esper256/smart-sewer-backup-detector/firmware/src/sewer-backup-detector.cpp

// Particle Photon 2 — sewer backup detector
// Device OS 5.3.2+. Edit config_and_secrets.h.
//
// Dry contact D2–GND, INPUT_PULLUP. Debug LED on D7.
// Closed (clear) => LOW => OFF. Open (sewer backup or cut wire) => HIGH => ON.
// ON/OFF are Home Assistant moisture binary_sensor payloads (on = Wet).
// Automations decide whether a sewer backup is an alarm.

#include "Particle.h"
#include "config_and_secrets.h"

#ifdef SEWER_TRANSPORT_HTTP
#include "HttpClient.h"
#endif
#ifdef SEWER_TRANSPORT_MQTT
#include "MQTT.h"
#endif

SYSTEM_THREAD(ENABLED);
SerialLogHandler logHandler(LOG_LEVEL_INFO);
STARTUP(WiFi.selectAntenna(ANT_EXTERNAL));

const pin_t CONTACT_PIN = D2;
const pin_t LED_PIN = D7;
const unsigned long SEWERBACKUP_DEBOUNCE_MS = 2000;
const unsigned long HEARTBEAT_MS = 60000;
const unsigned long RETRY_MS = 5000;
const auto WATCHDOG_TIMEOUT = 90s;
const char* const STATE_ON = "ON";
const char* const STATE_OFF = "OFF";

// contactOpenedAt is when the pin went open (0 = closed). sewerBackup is
// the latched condition after SEWERBACKUP_DEBOUNCE_MS.
static bool sewerBackup;
static unsigned long contactOpenedAt;

static const char* lastStateSentToHomeAssistant;
static unsigned long lastHomeAssistantSentAt;
static bool sendBackoff;
static unsigned long sendBackoffStartedAt;

static bool haDownSentToParticleCloud;
static const char* lastStateSentToParticleCloud;

#ifdef SEWER_TRANSPORT_HTTP
const uint16_t HTTP_TIMEOUT_MS = 4000;
HttpClient http;
http_header_t httpHeaders[] = {
    { "Content-Type", "application/json" },
    { NULL, NULL }
};
http_request_t httpRequest;
http_response_t httpResponse;
#endif

#ifdef SEWER_TRANSPORT_MQTT
const int MQTT_KEEPALIVE_S = 60;
const int MQTT_BUFFER_SIZE = 256;
const char* TOPIC_AVAILABILITY = "sewer/availability";
const char* TOPIC_STATE = "sewer/state";
void mqttCallback(char*, uint8_t*, unsigned int) {}  // MQTT constructor requires one; this device does not subscribe.
MQTT mqtt(MQTT_BROKER_IP, MQTT_BROKER_PORT, MQTT_BUFFER_SIZE, MQTT_KEEPALIVE_S, mqttCallback);
#endif

bool sendToParticleCloud(const char* event, const char* data) {
    return Particle.connected() && Particle.publish(event, data, PRIVATE);
}

#ifdef SEWER_TRANSPORT_HTTP
bool sendToHomeAssistant(const char* state) {
    if (!WiFi.ready()) {
        Log.warn("Wi-Fi not ready");
        return false;
    }
    httpRequest.body = String::format("{\"state\":\"%s\"}", state);
    http.post(httpRequest, httpResponse, httpHeaders);
    if (httpResponse.status != 200) {
        Log.warn("HTTP %d", httpResponse.status);
        return false;
    }
    return true;
}
#endif

#ifdef SEWER_TRANSPORT_MQTT
bool sendToHomeAssistant(const char* state) {
    if (!mqtt.isConnected()) {
        return false;
    }
    if (!mqtt.publish(TOPIC_STATE, state, true)) {
        Log.warn("mqtt publish failed");
        return false;
    }
    return true;
}

void connectToMqtt() {
    if (!WiFi.ready()) {
        return;
    }
    if (sendBackoff && millis() - sendBackoffStartedAt < RETRY_MS) {
        return;
    }
    sendBackoff = true;
    sendBackoffStartedAt = millis();

    String clientId = String("sewer-") + System.deviceID();
    if (!mqtt.connect(clientId.c_str(), MQTT_USERNAME, MQTT_PASSWORD,
                      TOPIC_AVAILABILITY, MQTT::QOS1, 1, "offline", true)) {
        Log.warn("mqtt connect failed");
        return;
    }
    mqtt.publish(TOPIC_AVAILABILITY, "online", true);
    lastStateSentToHomeAssistant = nullptr;
    sendBackoff = false;
    Log.info("mqtt connected");
}
#endif

void updateSewerBackup(bool contactOpen) {
    if (!contactOpen) {
        contactOpenedAt = 0;
        if (sewerBackup) {
            sewerBackup = false;
            Log.info("clear");
        }
        return;
    }
    if (sewerBackup) {
        return;
    }
    if (contactOpenedAt == 0) {
        contactOpenedAt = millis();
        Log.info("contact open");
        return;
    }
    if (millis() - contactOpenedAt >= SEWERBACKUP_DEBOUNCE_MS) {
        sewerBackup = true;
        Log.info("sewerBackup");
    }
}

void setup() {
    sewerBackup = false;
    contactOpenedAt = 0;
    lastStateSentToHomeAssistant = nullptr;
    lastHomeAssistantSentAt = 0;
    sendBackoff = false;
    sendBackoffStartedAt = 0;
    haDownSentToParticleCloud = false;
    lastStateSentToParticleCloud = nullptr;

    pinMode(LED_PIN, OUTPUT);
    pinMode(CONTACT_PIN, INPUT_PULLUP);

#ifdef SEWER_TRANSPORT_HTTP
    httpRequest.hostname = HA_HOST;
    httpRequest.port = HA_PORT;
    httpRequest.path = HA_WEBHOOK_PATH;
    httpRequest.timeout = HTTP_TIMEOUT_MS;
#endif

    Watchdog.init(WatchdogConfiguration().timeout(WATCHDOG_TIMEOUT));
    Watchdog.start();
    Log.info("setup complete");
}

void loop() {
    Watchdog.refresh();
#ifdef SEWER_TRANSPORT_MQTT
    if (mqtt.isConnected()) {
        mqtt.loop();
    } else {
        connectToMqtt();
    }
#endif

    const bool contactOpen = digitalRead(CONTACT_PIN) == HIGH;
    digitalWrite(LED_PIN, (contactOpen && ((millis() / 100) % 2)) ? HIGH : LOW);
    updateSewerBackup(contactOpen);

    const char* state = sewerBackup ? STATE_ON : STATE_OFF;

    const bool homeAssistantSendDue = lastStateSentToHomeAssistant != state ||
        (lastStateSentToHomeAssistant != nullptr &&
         millis() - lastHomeAssistantSentAt >= HEARTBEAT_MS);
    if (homeAssistantSendDue && (!sendBackoff || millis() - sendBackoffStartedAt >= RETRY_MS)) {
        if (sendToHomeAssistant(state)) {
            if (haDownSentToParticleCloud) {
                sendToParticleCloud("sewer-ha", "ok");
                haDownSentToParticleCloud = false;
            }
            lastStateSentToHomeAssistant = state;
            lastHomeAssistantSentAt = millis();
            sendBackoff = false;
        } else {
            sendBackoff = true;
            sendBackoffStartedAt = millis();
            if (!haDownSentToParticleCloud) {
#ifdef SEWER_TRANSPORT_HTTP
                if (WiFi.ready()) {
                    String err = String::format("HTTP %d", httpResponse.status);
                    haDownSentToParticleCloud =
                        sendToParticleCloud("sewer-ha", err.c_str());
                }
#endif
#ifdef SEWER_TRANSPORT_MQTT
                haDownSentToParticleCloud =
                    sendToParticleCloud("sewer-ha", "mqtt");
#endif
            }
        }
    }

    if (lastStateSentToParticleCloud != state) {
        if (sendToParticleCloud("sewer-state", state)) {
            lastStateSentToParticleCloud = state;
        }
    }

    delay(20);
}
