esper256/smart-sewer-backup-detector/firmware/src/config_and_secrets.h

#pragma once

// Fill in your Home Assistant address and webhook (or MQTT broker settings).
// HTTP is the default. Uncomment MQTT instead if you already run a broker.
#define SEWER_TRANSPORT_HTTP
// #define SEWER_TRANSPORT_MQTT

#if defined(SEWER_TRANSPORT_MQTT) && defined(SEWER_TRANSPORT_HTTP)
#error Define only one of SEWER_TRANSPORT_HTTP or SEWER_TRANSPORT_MQTT
#endif
#if !defined(SEWER_TRANSPORT_MQTT) && !defined(SEWER_TRANSPORT_HTTP)
#error Define SEWER_TRANSPORT_HTTP or SEWER_TRANSPORT_MQTT
#endif

#ifdef SEWER_TRANSPORT_HTTP
const char* HA_HOST = "192.168.0.2";
const int HA_PORT = 8123;
const char* HA_WEBHOOK_PATH = "/api/webhook/replacemewithyourwebhookid";
#endif

#ifdef SEWER_TRANSPORT_MQTT
const uint8_t MQTT_BROKER_IP[] = {192, 168, 0, 2};
const uint16_t MQTT_BROKER_PORT = 1883;
const char* MQTT_USERNAME = "replacemewithyourusername";
const char* MQTT_PASSWORD = "replacemewithyourpassword";
#endif
