esper256/smart-sewer-backup-detector/(commit log)

2026-08-26 HTTP-default instructable, host tests, Particle Cloud events (#1)
    * Rewrite instructable and harden Photon 2 firmware.
    Replace the wordy markdown with a short README covering purpose, cost,
    skills gate, build steps, firmware, and v2 notes. Publish a cleaned
    Photon 2 sketch: redact HA webhook secrets, fix the reed state machine
    and heartbeat retry, enable SYSTEM_THREAD plus the hardware watchdog,
    and add a Home Assistant automation example.
    * Switch telemetry to LAN MQTT; keep D7 LED; split secrets.
    Report reed OPEN/CLOSED on change and every 60s so Home Assistant can
    alert on backup, on a silent device, and on a notificatio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
    [config_and_secrets.h, sewer-backup-detector.cpp, test_firmware.cpp]
2026-08-26 Use English in the notes; add an Espressif comparison. (#2)
    camelCase sewerBackup stays in the C++ latch. Markdown and notify
    titles say sewer backup. Drop the hydrogen sulfide lecture. Close
    with what an ESP32/ESPHome build would change and what it would not.
2026-08-26 Select the Photon 2 U.FL antenna at boot.
    The module defaults to the chip antenna. Clicking a pigtail onto the
    U.FL does not move the RF switch. This install uses the external
    paddle, so STARTUP selects ANT_EXTERNAL (Device OS 5.3.2+).
2026-08-29 ESP32 vs Photon as a real choice (#3)
    * Make the ESP32 comparison a choice, not atmosphere.
    Say who should buy which board, how the two float wires land, and
    whose network Wi-Fi OTA actually uses. Particle's web IDE is a fleet
    console. A DevKit does not need the Photon proto-board job.
    * Rewrite the ESP32 notes as two build stories.
    Drop the comparison table and the slogans. Say what you solder,
    what you click in Home Assistant, and how firmware gets to the
    box later, for a Photon and for an ESP32.
    ---------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
